Nitrokey/nitrokey-lora-hardware/Assembly/nk-LoRa-BOM.xlsx

BOM - NITROKEY LoRa Rev.1
Reference | Quantity | Value | Footprint | Manufacturer Part Number | Distributer Link
ANT1 | 1 | 2450 MHZ ANTENNA | footprints:9520_WiFiChipAntenna | 2450AT45A100E | https://www.mouser.de/ProductDetail/Johanson-Technology/2450AT45A100E
ANT2 | 1 | 868 MHZ ANTENNA | footprints:Ant_868MHz_0868AT43A0020E | 0868AT43A0020E | https://www.digikey.com/product-detail/en/johanson-technology-inc/0868AT43A0020E/712-1399-1-ND/1833757
C14 | 1 | 100pF | Capacitor_SMD:C_0402_1005Metric | GRM1555C1H101FA01J | https://www.mouser.de/ProductDetail/Murata-Electronics/GRM1555C1H101FA01J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
C16 C8 | 2 | 10uF | Capacitor_SMD:C_0603_1608Metric | GRM188R61A106KE69J | https://www.mouser.de/ProductDetail/Murata-Electronics/GRM188R61A106KE69J
C1 C12 C13 C17 | 4 | 1uF | Capacitor_SMD:C_0402_1005Metric | GRM155C81A105KA12D | https://www.mouser.de/ProductDetail/Murata-Electronics/GRM155C81A105KA12D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
C18 | 1 | 10n | Capacitor_SMD:C_0402_1005Metric | GRM155R71E103KA01D | https://www.mouser.de/ProductDetail/Murata-Electronics/GRM155R71E103KA01D
C19 | 1 | 4.7pF | Capacitor_SMD:C_0402_1005Metric | GJM1555C1H2R4CB01D | https://www.mouser.de/ProductDetail/Murata-Electronics/GJM1555C1H2R4CB01D
C2 C3 | 2 | 22pF/6.3V(10%) | Capacitor_SMD:C_0402_1005Metric | GRM1555C1H220FA01D (https://www.mouser.de/ProductDetail/Murata-Electronics/GRM1555C1H220FA01D) | https://www.mouser.de/ProductDetail/Murata-Electronics/GRM1555C1H220FA01D
C20 | 1 | 2.4pF | Capacitor_SMD:C_0402_1005Metric | GJM1555C1H2R4CB01J | https://www.mouser.de/ProductDetail/Murata-Electronics/GJM1555C1H2R4CB01J
C21 | 1 | 470nF | Capacitor_SMD:C_0402_1005Metric | GRM155R61A474KE15D | https://www.mouser.de/ProductDetail/Murata-Electronics/GRM155R61A474KE15D
C23 C25 C28 C31 | 4 | 3.3pF | Capacitor_SMD:C_0402_1005Metric | GRM1555C1H3R3BA01D | https://www.mouser.de/ProductDetail/Murata-Electronics/GRM1555C1H3R3BA01D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
C27 C40 | 2 | 1.8pF | Capacitor_SMD:C_0402_1005Metric | GRM1555C1H1R8BA01D | https://www.mouser.de/_/?Keyword=GRM1555C1H1R8BA01D
C26 C29 | 2 | 15pF | Capacitor_SMD:C_0402_1005Metric | GRM1555C1H150JA01D | https://www.mouser.de/ProductDetail/Murata-Electronics/GRM1555C1H150JA01D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
C30 | 1 | 12pF | Capacitor_SMD:C_0402_1005Metric | GRM1555C1H120JA01J | https://www.mouser.de/ProductDetail/Murata-Electronics/GRM1555C1H120JA01J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
C35 | 1 | 3.0pF | Capacitor_SMD:C_0402_1005Metric | GRM1555C1H3R0BA01D | https://www.mouser.de/ProductDetail/Murata-Electronics/GRM1555C1H3R0BA01D?qs=ouTquLLW2S5g5Yak4wnjeg%3D%3D
C37 | 1 | 47nF | Capacitor_SMD:C_0402_1005Metric | GRM155R71C473KA01J | https://www.mouser.de/ProductDetail/Murata-Electronics/GRM155R71C473KA01J
C38 | 1 | 47pF | Capacitor_SMD:C_0402_1005Metric | GJM1555C1H470FB01D | https://www.mouser.de/ProductDetail/Murata-Electronics/GJM1555C1H470FB01D
C39 | 1 | 6.8pF | Capacitor_SMD:C_0402_1005Metric | GRM1555C1H6R8BA01D | https://www.mouser.de/ProductDetail/Murata-Electronics/GRM1555C1H6R8BA01D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
C22 C4 | 2 | 10nF | Capacitor_SMD:C_0402_1005Metric | GRM155R71E103KA01D | https://www.mouser.de/ProductDetail/Murata-Electronics/GRM155R71E103KA01D
C41 | 1 | 1.0pF | Capacitor_SMD:C_0402_1005Metric | GRM1555C1H1R0BA01D | https://www.mouser.de/ProductDetail/Murata-Electronics/GRM1555C1H1R0BA01D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
C5 | 1 | 3,3nF | Capacitor_SMD:C_0402_1005Metric | GRM155R71H332JA01D | https://www.mouser.de/ProductDetail/Murata-Electronics/GRM155R71H332JA01D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
C7 | 1 | 22pF | Capacitor_SMD:C_0402_1005Metric | GRM1555C1H220JA01D | https://www.mouser.de/ProductDetail/Murata-Electronics/GRM1555C1H220JA01D
C10 C11 C15 C24 C6 C9 | 6 | 0.1uF | Capacitor_SMD:C_0402_1005Metric | GRM155R71C104KA88D | https://www.mouser.de/ProductDetail/Murata-Electronics/GRM155R71C104KA88D
D1 | 1 | LED_0402 | LED_SMD:LED_0402_1005Metric | APHHS1005SURCK | https://www.mouser.de/ProductDetail/Kingbright/APHHS1005SURCK
L1 | 1 | 2.4nH | Inductor_SMD:L_0402_1005Metric | LQP15MN2N4B02D | https://www.mouser.de/ProductDetail/Murata-Electronics/LQP15MN2N4B02D
L10 | 1 | 18nH | Inductor_SMD:L_0402_1005Metric | LQW15AN18NH00D | https://www.mouser.de/ProductDetail/Murata-Electronics/LQW15AN18NH00D
L12 | 1 | 2.7nH | Inductor_SMD:L_0402_1005Metric | LQW15AN2N7C00D | https://www.mouser.de/ProductDetail/Murata-Electronics/LQW15AN2N7C00D
L11 L2 | 2 | 47nH | Inductor_SMD:L_0402_1005Metric | LQW15AN47NJ00D | https://www.mouser.de/ProductDetail/Murata-Electronics/LQW15AN47NJ00D
L3 L5 | 2 | 9.1nH | Inductor_SMD:L_0402_1005Metric | LQW15AN9N1H00D | https://www.mouser.de/ProductDetail/Murata-Electronics/LQW15AN9N1H00D
L9 | 1 | 15uH | Inductor_SMD:L_0805_2012Metric | MLZ2012M150W | https://www.mouser.de/ProductDetail/TDK/MLZ2012M150WTD25
Q1 | 1 | MBT3904DW1T1G | Package_TO_SOT_SMD:SOT-363_SC-70-6 | http://www.onsemi.com/pub/Collateral/MBT3904DW1T1-D.PDF | https://www.mouser.de/ProductDetail/ON-Semiconductor/MBT3904DW1T1G
R10 R12 R4 R9 | 4 | 10K | Resistor_SMD:R_0402_1005Metric | http://www.vishay.com/docs/20035/dcrcwe3.pdf | https://www.mouser.de/ProductDetail/Vishay-Dale/CRCW040210K0FKED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
R13 R14 R15 R16 R17 R18 | 6 | 47K | Resistor_SMD:R_0402_1005Metric | http://www.vishay.com/docs/20035/dcrcwe3.pdf | Vishay Standard
R19 | 1 | 50K | Resistor_SMD:R_0402_1005Metric | http://www.vishay.com/docs/20035/dcrcwe3.pdf | Vishay Standard
R1 R11 R2 | 3 | 1K | Resistor_SMD:R_0402_1005Metric | http://www.vishay.com/docs/20035/dcrcwe3.pdf | Vishay Standard
R20 R21 | 2 | 100R | Resistor_SMD:R_0402_1005Metric | http://www.vishay.com/docs/20035/dcrcwe3.pdf | Vishay Standard
R3 | 1 | 20K | Resistor_SMD:R_0402_1005Metric | http://www.vishay.com/docs/20035/dcrcwe3.pdf | Vishay Standard
R5 | 1 | 390R | Resistor_SMD:R_0402_1005Metric | http://www.vishay.com/docs/20035/dcrcwe3.pdf | Vishay Standard
R6 | 1 | 1M | Resistor_SMD:R_0402_1005Metric | http://www.vishay.com/docs/20035/dcrcwe3.pdf | Vishay Standard
R7 | 1 | 22.1K | Resistor_SMD:R_0402_1005Metric | http://www.vishay.com/docs/20035/dcrcwe3.pdf | Vishay Standard
R8 | 1 | 47.5K | Resistor_SMD:R_0402_1005Metric | http://www.vishay.com/docs/20035/dcrcwe3.pdf | Vishay Standard
U1 | 1 | TLV75733PDBVR | footprints:SOT-23-5 | TLV75733PDBVR | https://www.mouser.de/ProductDetail/Texas-Instruments/TLV75733PDBVR
U2 | 1 | ESP32-D0WD | Package_DFN_QFN:QFN-48-1EP_5x5mm_P0.35mm_EP3.7x3.7mm_ThermalVias | Smd Ic Esp32-D0wd, Dual Core Mcu, Espressif Systems | https://www.mouser.de/ProductDetail/Espressif-Systems/ESP32-D0WD
U3 | 1 | SX1261IMLTRT | footprints:QFN-24-1EP_4x4mm_P0.5mm_EP2.7x2.7mm_ThermalVias | RF Transceiver FSK 1.8V to 3.7V 150MHz to 960MHz 24-Pin QFN | https://www.mouser.de/ProductDetail/Semtech/SX1261IMLTRT?qs=XFmntM7Yc9ddMzW%252Bp3zsFQ==
U4 | 1 | DF5A5.6JE | Package_TO_SOT_SMD:SOT-553 | http://optoelectronics.liteon.com/upload/download/DS22-2008-0044/S_110_LTST-C19HE1WT.pdf | https://www.mouser.de/ProductDetail/Toshiba/DF5A56JELM
U5 | 1 | CP2102N-A01-GQFN24 | Package_DFN_QFN:QFN-24-1EP_4x4mm_P0.5mm_EP2.6x2.6mm | CP2102N-A01-GQFN24 | https://www.mouser.de/ProductDetail/Silicon-Labs/CP2102N-A01-GQFN24
U6 | 1 | RF-Switch_pSemi_4259-63 | footprints:SC-70-6 | RF-Switch_pSemi_4259-63 | https://www.digikey.com/product-detail/en/psemi/4259-63/1046-1011-1-ND/2614515
X1 | 1 | FA-128 40MHz | Crystal:Crystal_SMD_2016-4Pin_2.0x1.6mm | FA-128 40MHz | https://www.digikey.com/product-detail/en/epson/FA-128-40.0000MF10Z-K3/SER3753CT-ND/2514633
X2 | 1 | USB_Plug | footprints:USB-A-PLUG | USB_Plug | 0480372200_sd
X3 | 1 | Micro_SD_Card_Molex_475710001 | footprints:47571-0001 | Micro_SD_Card_Molex_475710001 | https://www.digikey.de/product-detail/de/molex/0475710001/WM9731CT-ND/4037907
Y1 | 1 | Q 32,0-JXS21-10-10/10-FU-WA-LF | Crystal:Crystal_SMD_2016-4Pin_2.0x1.6mm | Q 32,0-JXS21-10-10/10-FU-WA-LF | https://www.digikey.com/product-detail/en/jauch-quartz/Q-320-JXS21-10-10-10-FU-WA-LF/1908-1280-1-ND/8108392
