Nitrokey/nitrokey-lora-hardware/3DLib/case_top.dxf

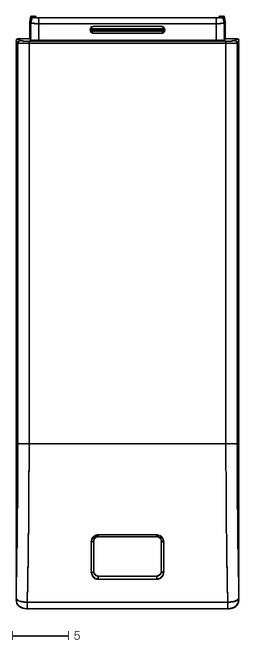
[picture p1: CAD file, 2019-06-24]
3DLib/case_top.dxf
19.8 x 52.6
