Nitrokey/nitrokey-lora-hardware/3DLib/AN9520.step

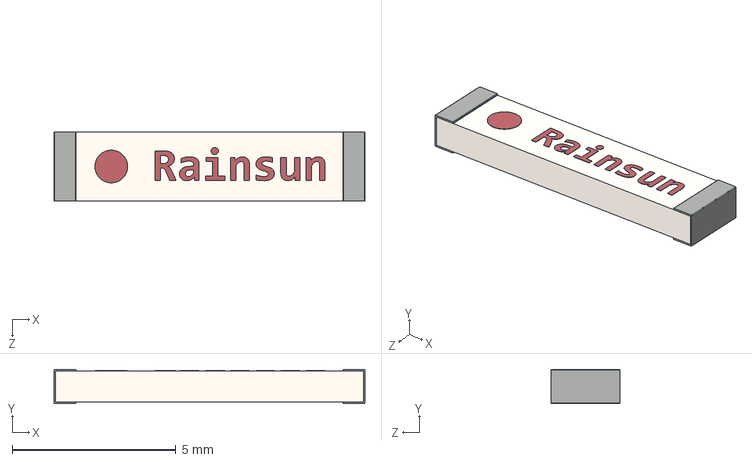
[picture p2: CAD file, 2019-06-24]
3DLib/AN9520.step
9.50 x 1.05 x 2.10 mm
