Nitrokey/nitrokey-lora-hardware/3DLib/Micro_SD.step

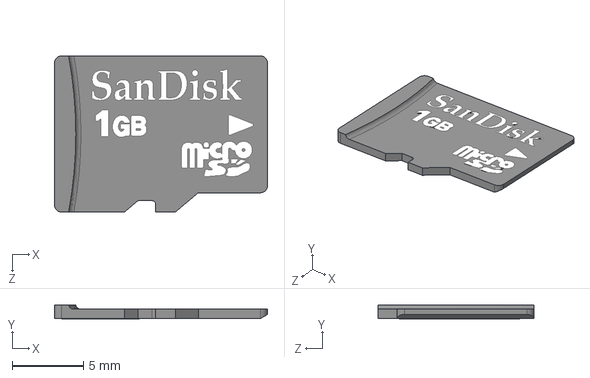
[picture p3: CAD file, 2019-06-24]
3DLib/Micro_SD.step
15.0 x 0.975 x 11.0 mm
