Nitrokey/nitrokey-lora-hardware/3DLib/case_bottom.step

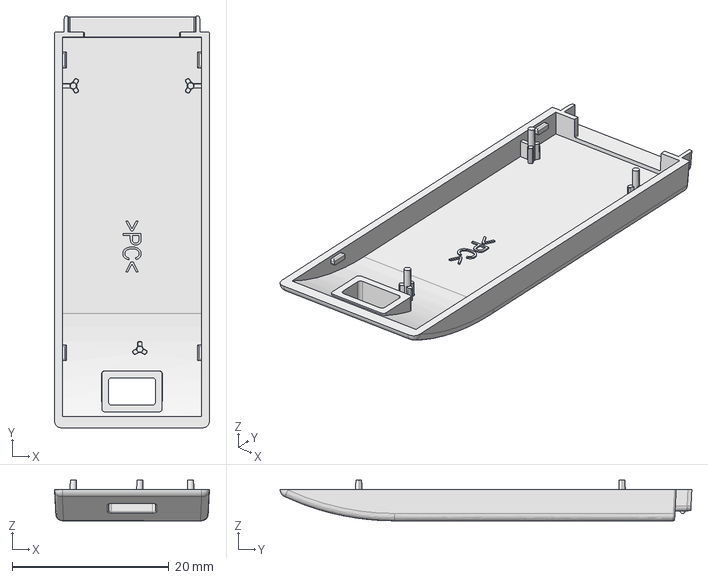
[picture p4: CAD file, 2019-06-24]
3DLib/case_bottom.step
19.8 x 52.6 x 5.20 mm
