Nitrokey/nitrokey-lora-hardware/3DLib/case_bottom+pcb.dxf

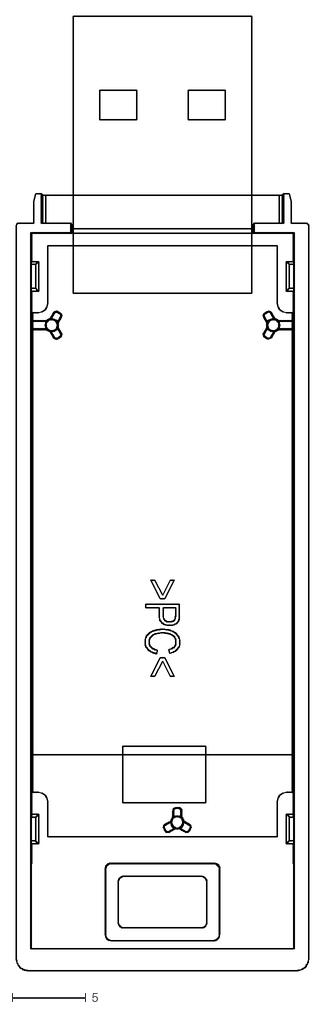
[picture p5: CAD file, 2019-06-24]
3DLib/case_bottom+pcb.dxf
19.8 x 64.6
