Nitrokey/nitrokey-lora-hardware/3DLib/case_cap.dxf

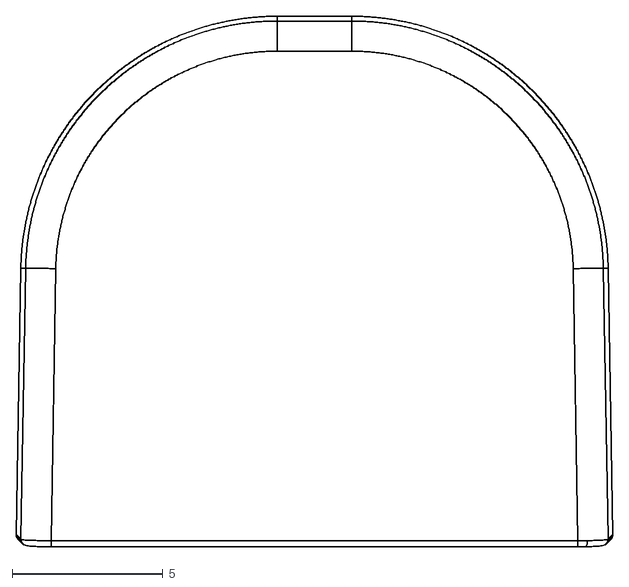
[picture p6: CAD file, 2019-06-24]
3DLib/case_cap.dxf
19.8 x 17.6
