Nitrokey/nitrokey-lora-hardware/3DLib/sot363_sc70_6.step

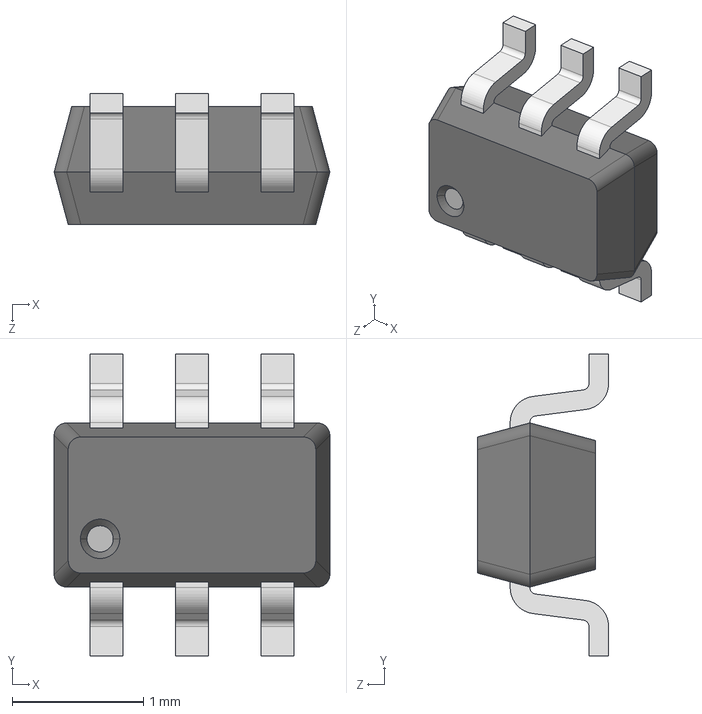
[picture p7: CAD file, 2019-06-24]
3DLib/sot363_sc70_6.step
2.10 x 2.30 x 1.00 mm
