Nitrokey/nitrokey-lora-hardware/3DLib/Crystal 2.0mm x 1.6mm x 0.7mm.step

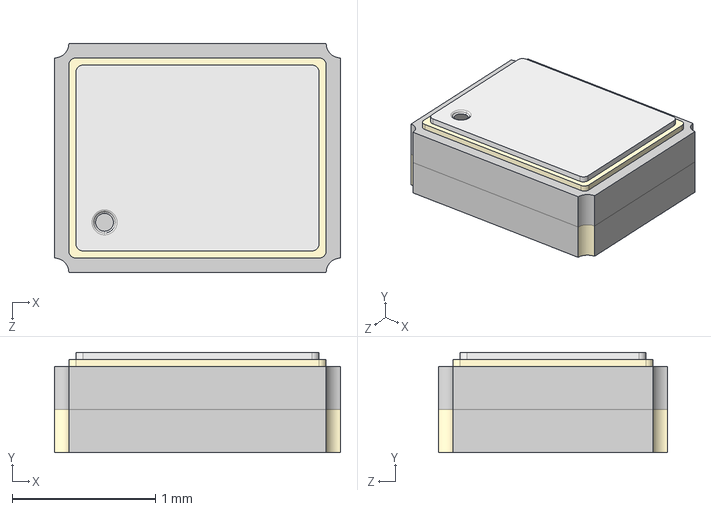
[picture p8: CAD file, 2019-06-24]
3DLib/Crystal 2.0mm x 1.6mm x 0.7mm.step
2.00 x 0.701 x 1.60 mm
