Nitrokey/nitrokey-lora-hardware/3DLib/QFN-48-1EP_5x5mm_P0.35mm_EP3.7x3.7mm.step

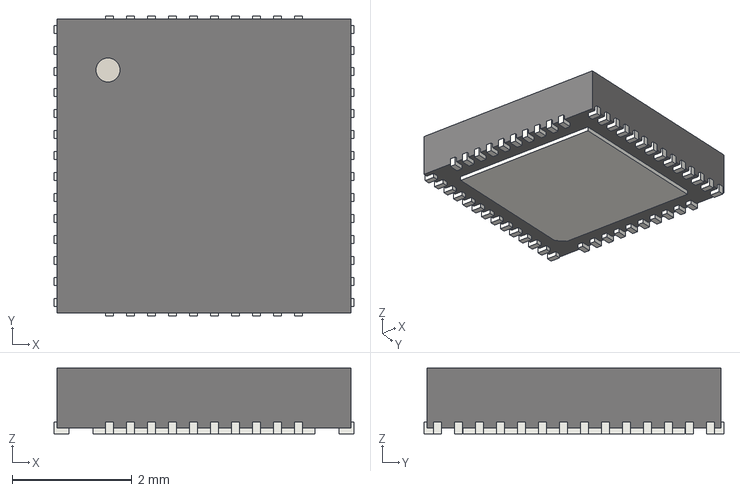
[picture p9: CAD file, 2019-06-24]
3DLib/QFN-48-1EP_5x5mm_P0.35mm_EP3.7x3.7mm.step
5.00 x 5.00 x 1.10 mm
