Nitrokey/nitrokey-lora-hardware/3DLib/User Library-0868AT43A0020.step

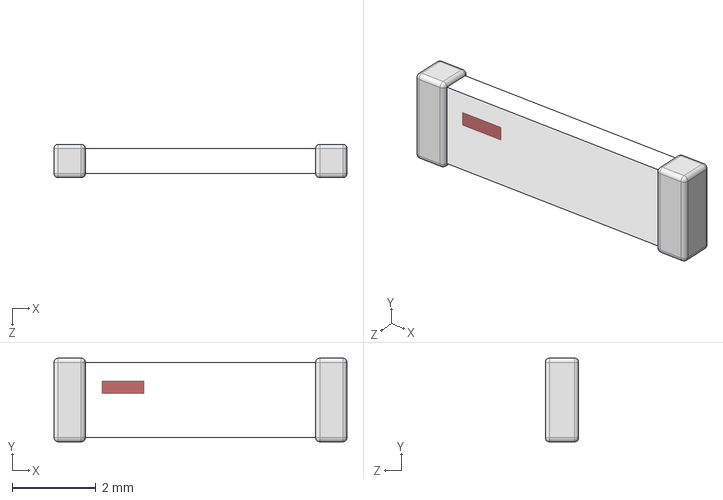
[picture p10: CAD file, 2019-06-24]
3DLib/User Library-0868AT43A0020.step
7.00 x 2.00 x 0.8 mm
