Nitrokey/nitrokey-lora-hardware/3DLib/case_top_cap.step

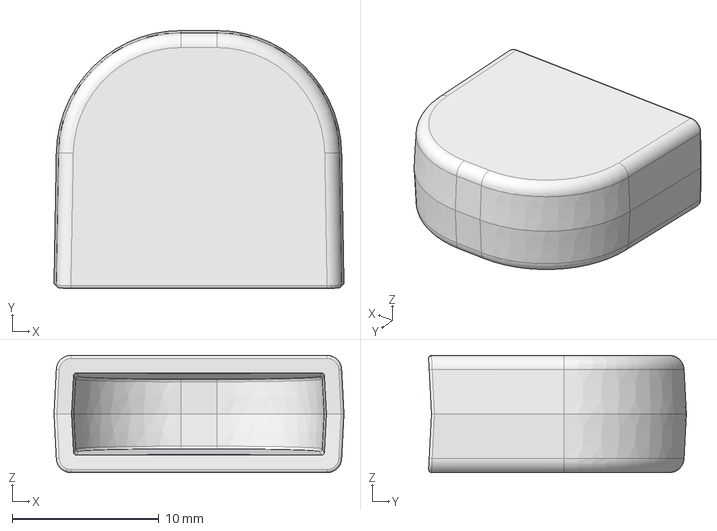
[picture p11: CAD file, 2019-06-24]
3DLib/case_top_cap.step
19.8 x 17.6 x 8.00 mm
