Nitrokey/nitrokey-lora-hardware/3DLib/top_case.step

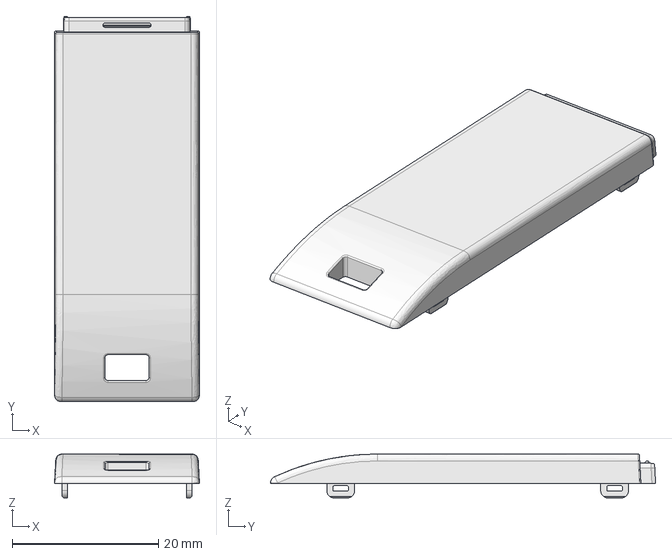
[picture p12: CAD file, 2019-06-24]
3DLib/top_case.step
19.8 x 52.6 x 6.00 mm
