Nitrokey/nitrokey-lora-hardware/3DLib/QFN24.step

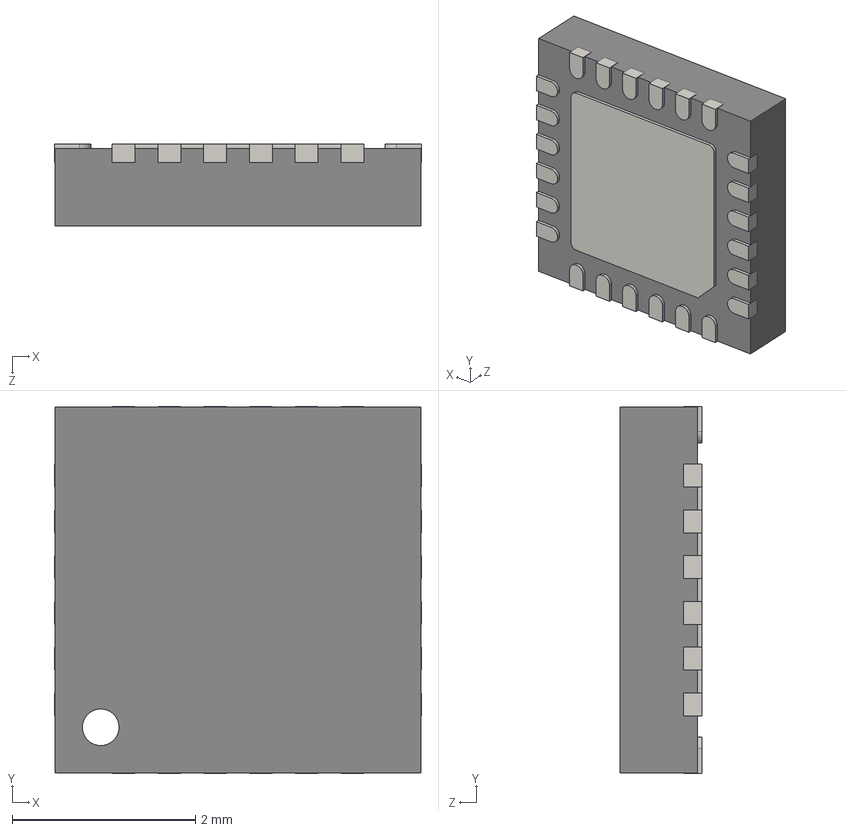
[picture p13: CAD file, 2019-06-24]
3DLib/QFN24.step
4.01 x 4.01 x 0.9 mm
