Nitrokey/nitrokey-lora-hardware/3DLib/1462360101.stp

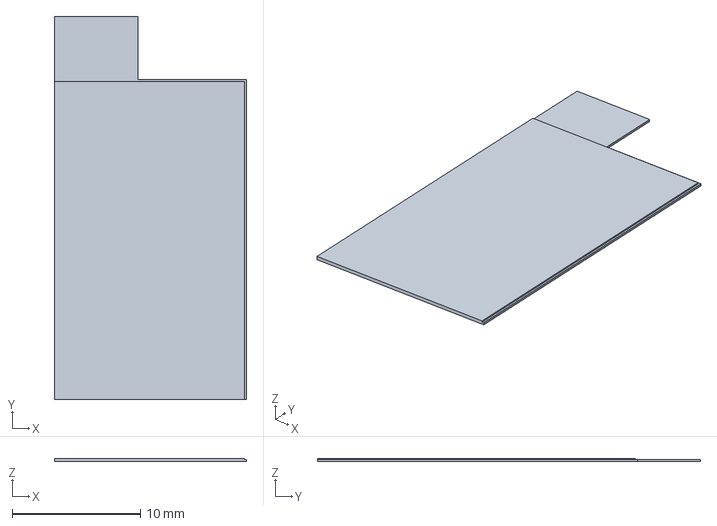
[picture p14: CAD file, 2019-06-24]
3DLib/1462360101.stp
15.0 x 29.9 x 0.27 mm
