Nitrokey/nitrokey-lora-hardware/3DLib/475710001.stp

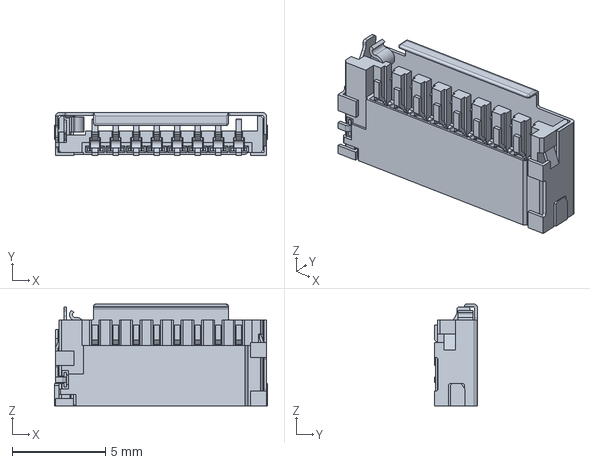
[picture p15: CAD file, 2019-06-24]
3DLib/475710001.stp
11.4 x 2.30 x 5.45 mm
