Nitrokey/nitrokey-lora-hardware/3DLib/1040310811.stp

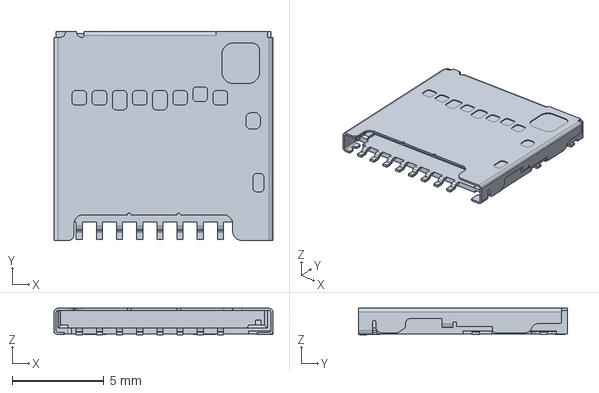
[picture p16: CAD file, 2019-06-24]
3DLib/1040310811.stp
11.9 x 11.4 x 1.45 mm
