Nitrokey/nitrokey-lora-hardware/3DLib/1140084168_3d.STEP

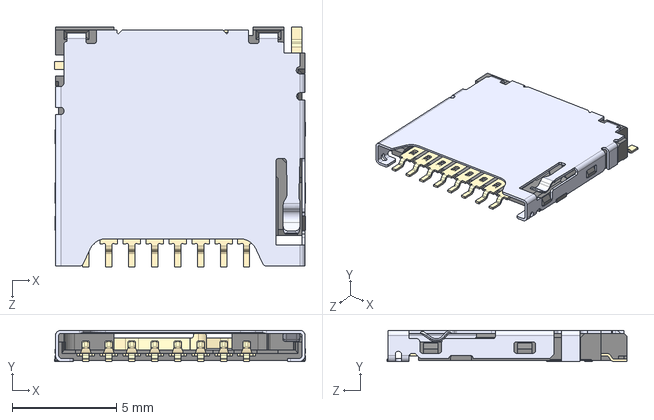
[picture p17: CAD file, 2019-06-24]
3DLib/1140084168_3d.STEP
12.0 x 1.50 x 11.5 mm
