Nitrokey/nitrokey-lora-hardware/(list of files, cad)

Other CAD files:
3DLib/case_bottom.dxf
