Nitrokey/nitrokey-lora-hardware/nk-LoRa_Schaltplan.pdf

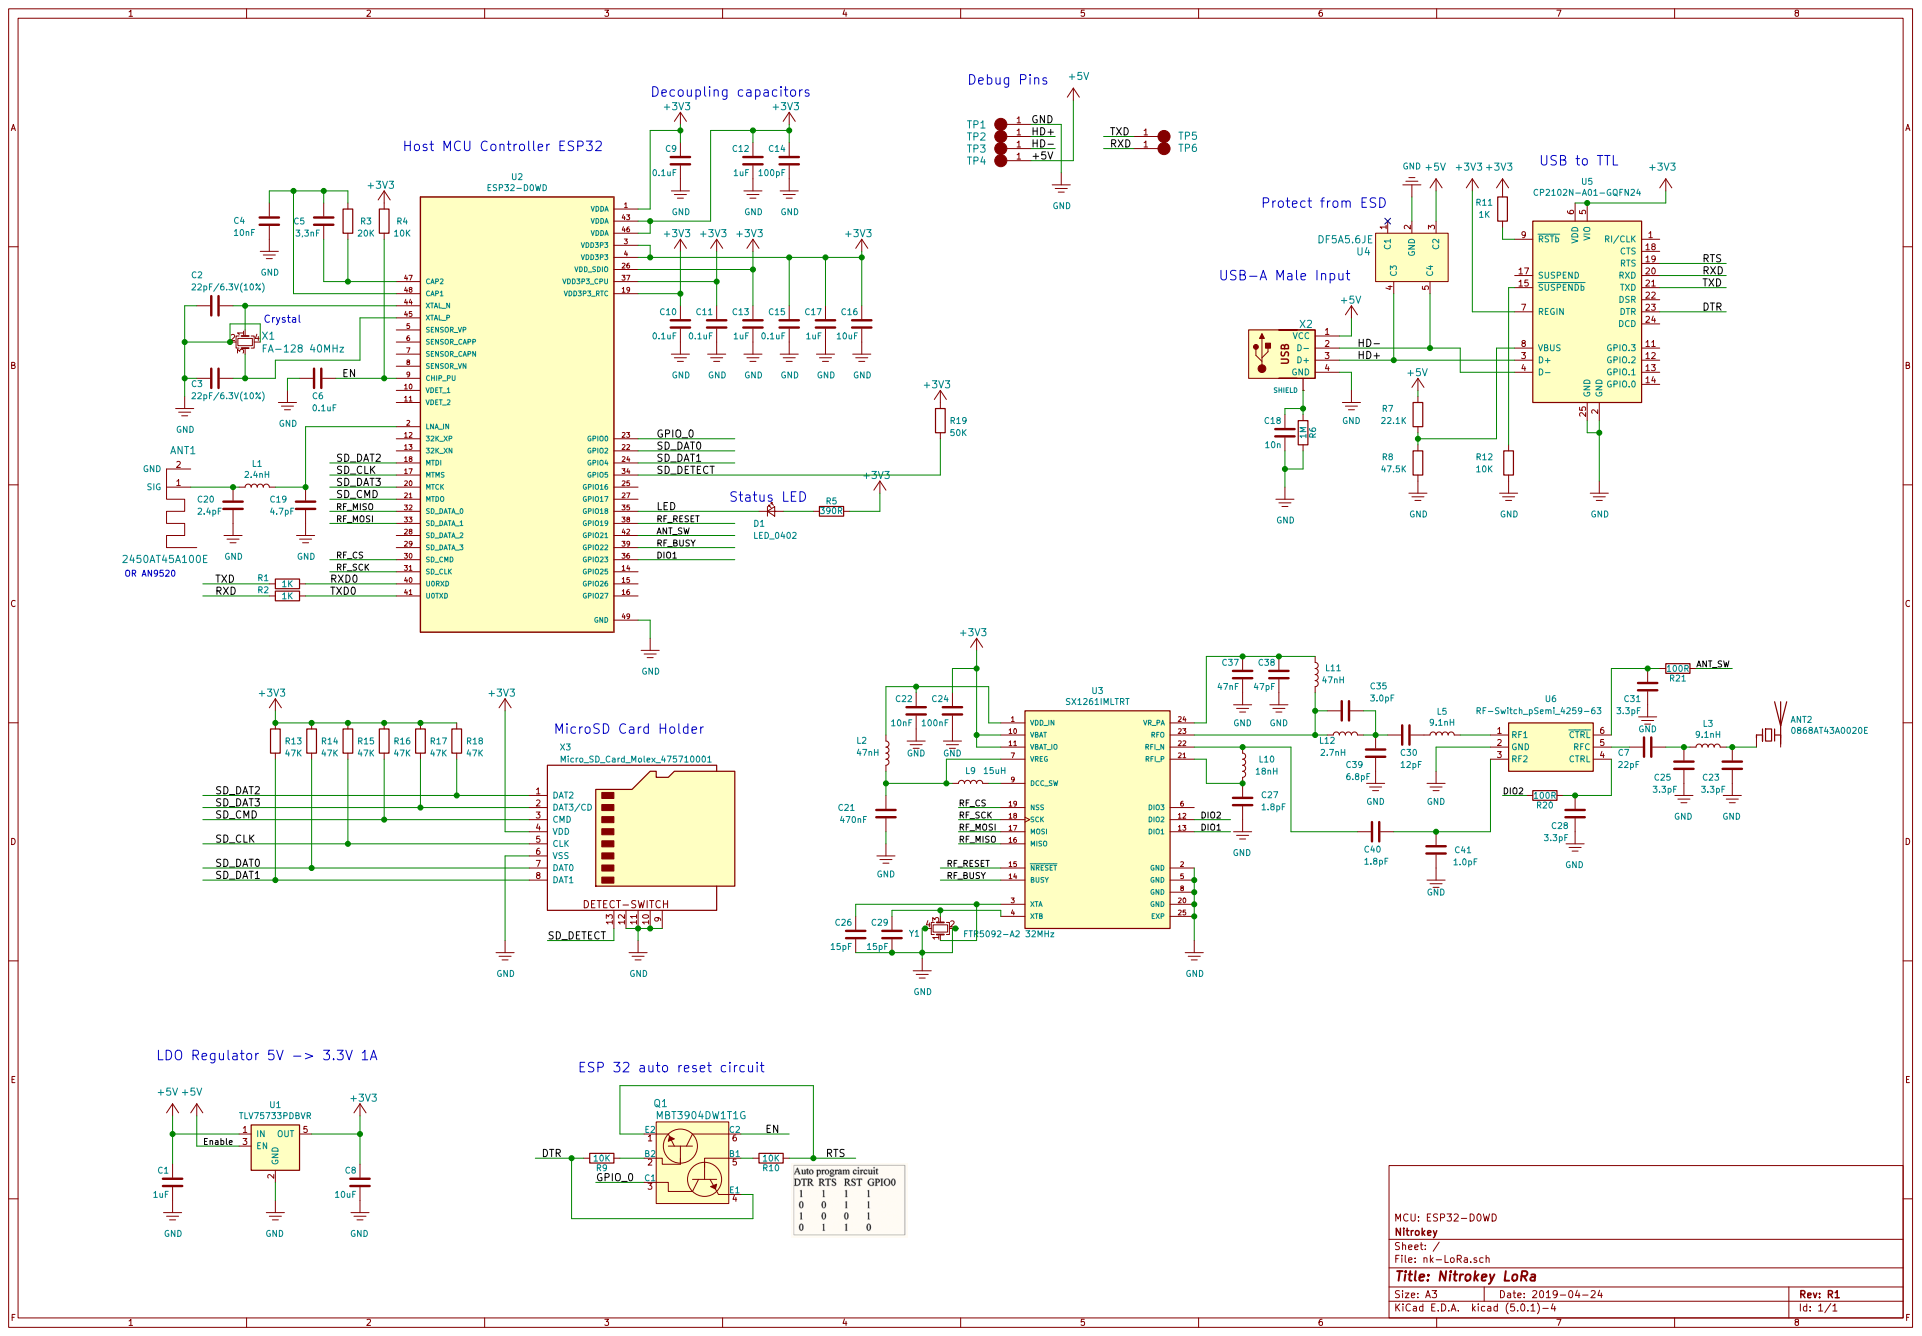
[picture p18: page 1]

TXD
RXD
File: nk-LoRa.sch Sheet: / Nitrokey MCU: ESP32-D0WD C1

LED Host MCU Controller ESP32

6 REGIN 7 VBUS 8 RSTb 9 U5 CP2102N-A01-GQFN24 GND
1 GPIO.3
RI/CLK
18 RTS

+5V ESP 32 auto reset circuit

Id: 1/1 Title: Nitrokey LoRa
