Nitrokey/nitrokey-lora-hardware/nk-LoRa.kicad_pcb

## KiCad design nk-LoRa.kicad_pcb (2019-07-25)

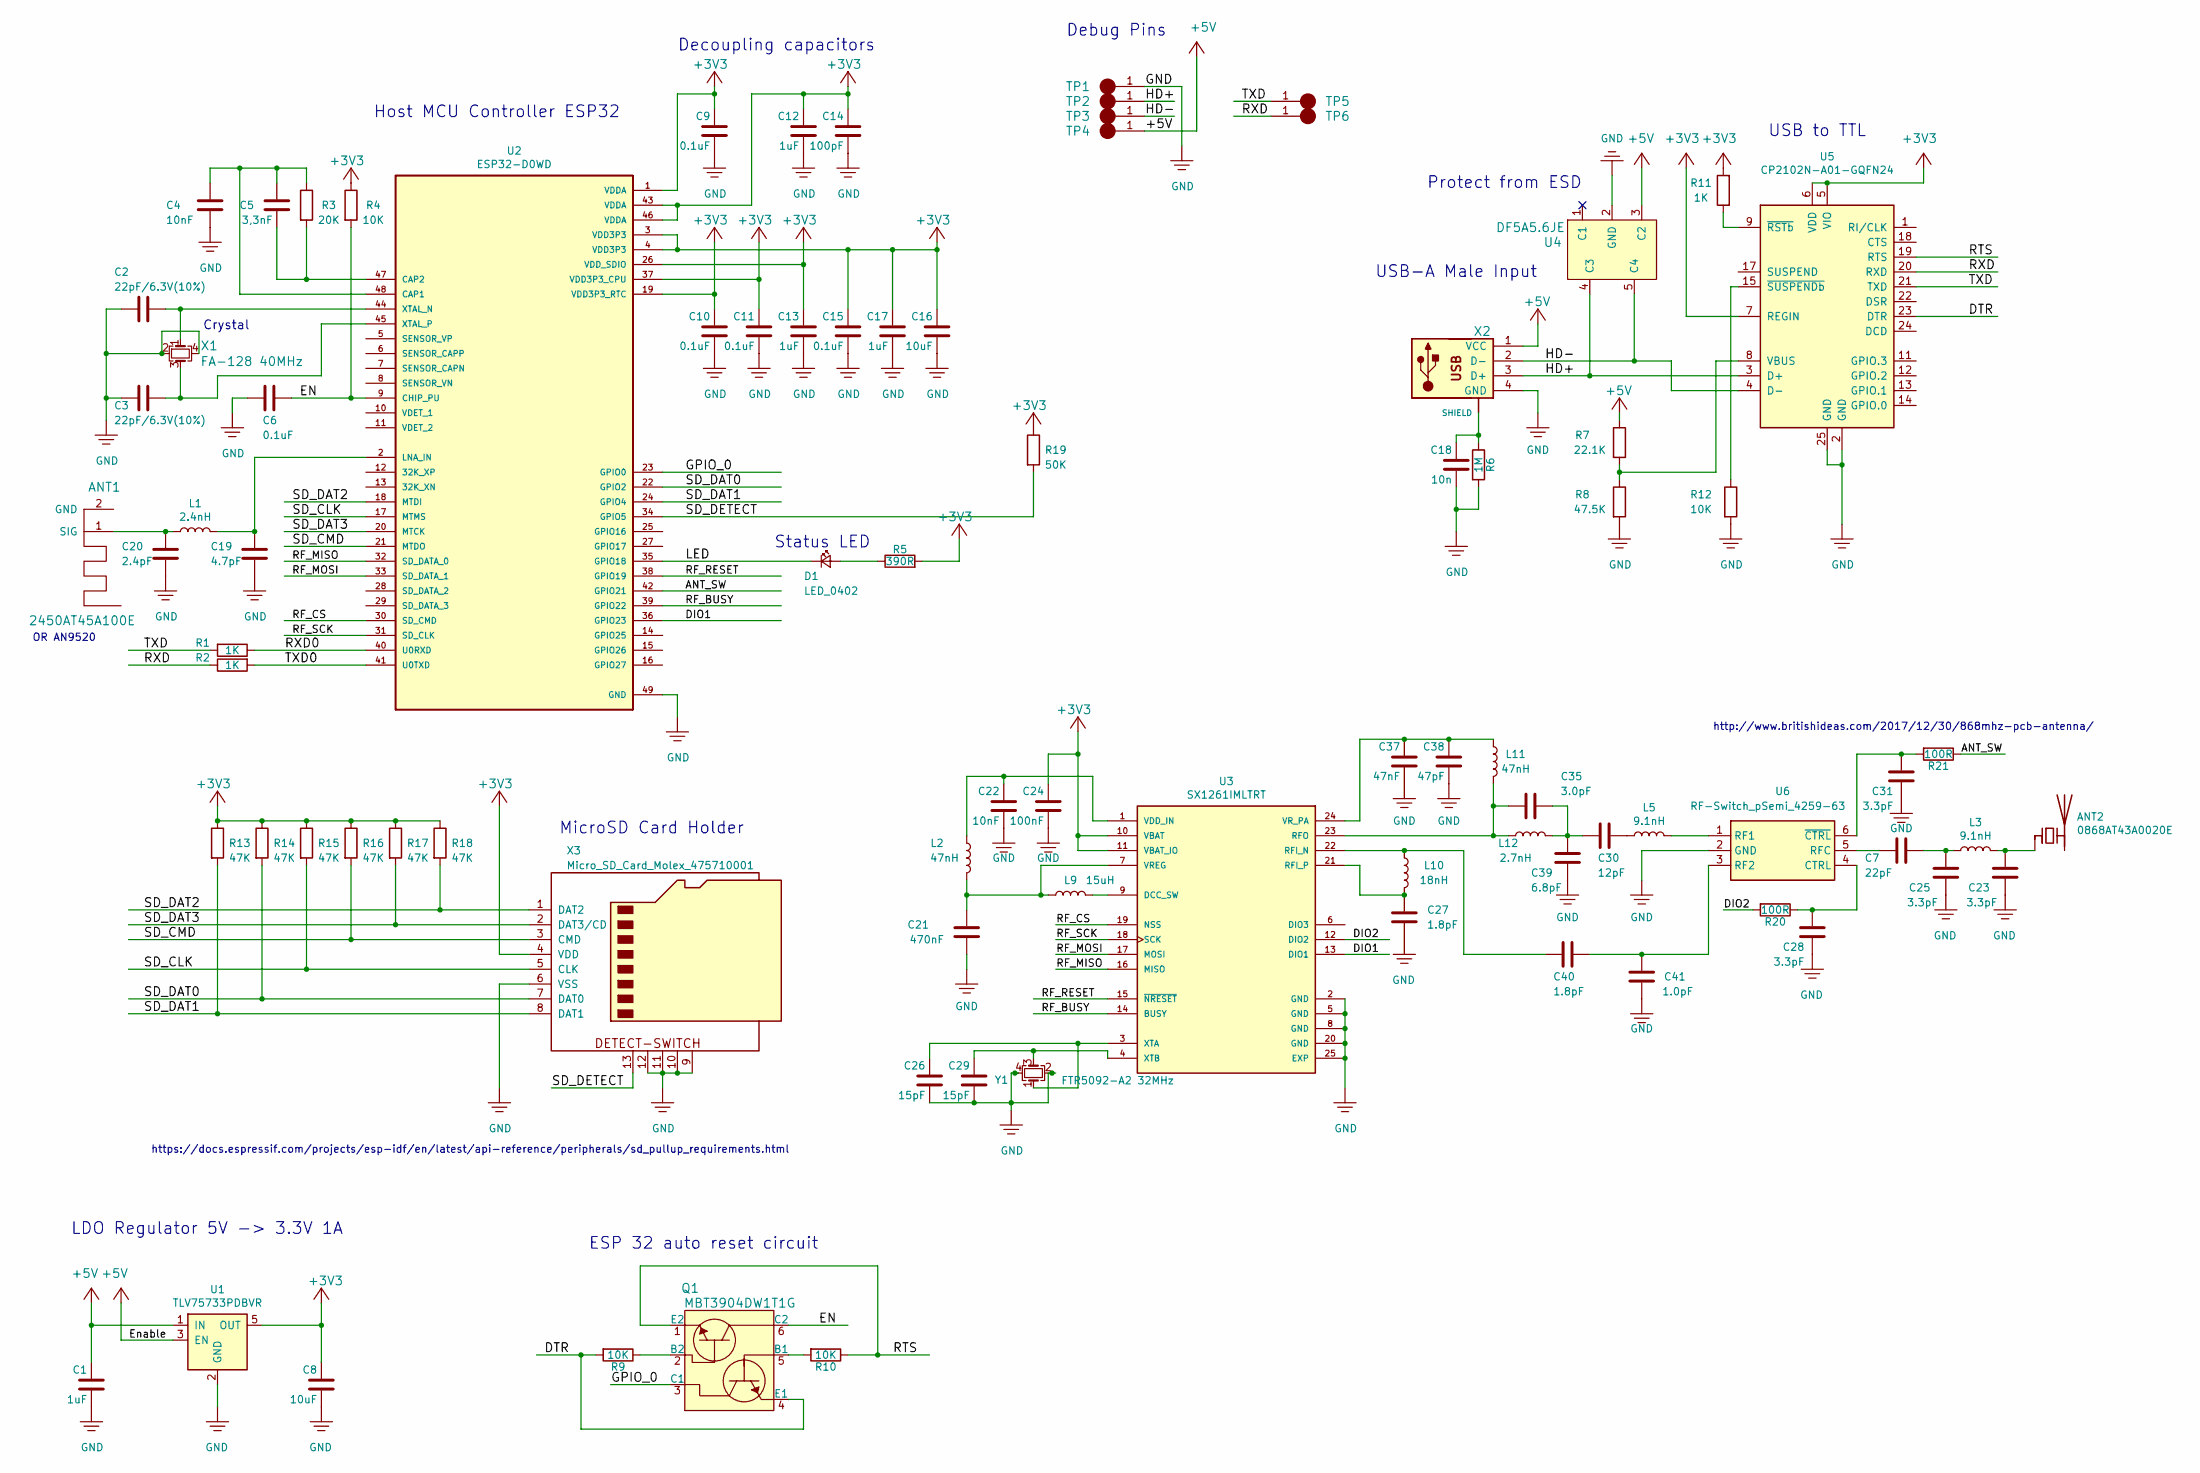
[picture p28: schematic nk-LoRa.sch, Nitrokey LoRa]

Parts:
ANT1: 2450AT45A100E; 9520_WiFiChipAntenna
ANT2: 0868AT43A0020E; Ant_868MHz_0868AT43A0020E
C1, C12, C13, C17: 1uF; C_0402_1005Metric; MFG Part Num ?
C2, C3: 22pF/6.3V(10%); C_0402_1005Metric; MFG Part Num ?
C4, C22: 10nF; C_0402_1005Metric; MFG Part Num ?
C5: 3,3nF; C_0402_1005Metric; MFG Part Num ?
C6, C9, C10, C11, C15: 0.1uF; C_0402_1005Metric; MFG Part Num ?
C7: 22pF; C_0402_1005Metric
C8, C16: 10uF; C_0603_1608Metric; MFG Part Num ?
C14: 100pF; C_0402_1005Metric; MFG Part Num ?
C18: 10n; C_0402_1005Metric; MFG Part Num ?
C19: 4.7pF; C_0402_1005Metric
C20: 2.4pF; C_0402_1005Metric
C21: 470nF; C_0402_1005Metric; MFG Part Num GRM155R61A474KE15D
C23, C25, C28, C31: 3.3pF; C_0402_1005Metric
C24: 100nF; C_0402_1005Metric; MFG Part Num GRM155R71C104KA88D
C26, C29: 15pF; C_0402_1005Metric; MFG Part Num GRM1555C1H150JA01D
C27, C40: 1.8pF; C_0402_1005Metric; MFG Part Num GRM1555C1H1R8BA01D
C30: 12pF; C_0402_1005Metric
C35: 3.0pF; C_0402_1005Metric; MFG Part Num GRM1555C1H3R0BA01D
C37: 47nF; C_0402_1005Metric; MFG Part Num ?
C38: 47pF; C_0402_1005Metric; MFG Part Num ?
C39: 6.8pF; C_0402_1005Metric; MFG Part Num GRM1555C1H6R8BA01D
C41: 1.0pF; C_0402_1005Metric
D1: LED_0402; LED_0402_1005Metric
L1: 2.4nH; L_0402_1005Metric; Part.Nr LQP15MN2N4B02D
L2, L11: 47nH; L_0402_1005Metric; Part.Nr LQW15AN47NJ00D
L3, L5: 9.1nH; L_0402_1005Metric; Part.Nr LQW15AN9N1H00D
L9: 15uH; L_0805_2012Metric; Part.Nr MLZ2012M150W
L10: 18nH; L_0402_1005Metric; Part.Nr LQW15AN18NH00D
L12: 2.7nH; L_0402_1005Metric; Part.Nr LQW15AN2N7C00D
Q1: MBT3904DW1T1G; SOT-363_SC-70-6; MPN MBT3904DW1T1G; Digi-Key_PN MBT3904DW1T1GOSCT-ND
R1, R2, R11: 1K; R_0402_1005Metric; MFG Part Num ?
R3: 20K; R_0402_1005Metric; MFG Part Num ?
R4, R9, R10, R12: 10K; R_0402_1005Metric; MFG Part Num ?
R5: 390R; R_0402_1005Metric; MFG Part Num ?
R6: 1M; R_0402_1005Metric; MFG Part Num ?
R7: 22.1K; R_0402_1005Metric; MFG Part Num ?
R8: 47.5K; R_0402_1005Metric; MFG Part Num ?
R13, R14, R15, R16, R17, R18: 47K; R_0402_1005Metric; MFG Part Num ?
R19: 50K; R_0402_1005Metric; MFG Part Num ?
R20, R21: 100R; R_0402_1005Metric; MFG Part Num ?
TP1, TP2, TP3, TP4, TP5, TP6: debug-pin; Prog_Pad_Circular
U1: TLV75733PDBVR; SOT-23-5
U2: ESP32-D0WD; QFN-48-1EP_5x5mm_P0.35mm_EP3.7x3.7mm_ThermalVias
U3: SX1261IMLTRT; QFN-24-1EP_4x4mm_P0.5mm_EP2.7x2.7mm_ThermalVias
U4: DF5A5.6JE; SOT-553; MFG Part Num DF5A5.6JE,LM
U5: CP2102N-A01-GQFN24; QFN-24-1EP_4x4mm_P0.5mm_EP2.6x2.6mm
U6: RF-Switch_pSemi_4259-63; SC-70-6
X1: FA-128 40MHz; Crystal_SMD_2016-4Pin_2.0x1.6mm
X2: USB_Plug; USB-A-PLUG
X3: Micro_SD_Card_Molex_475710001; 47571-0001
Y1: FTR5092-A2 32MHz; Crystal_SMD_2016-4Pin_2.0x1.6mm

Connections:
+3V3: C8.1, C9.1, C10.1, C11.1, C12.1, C13.1, C14.1, C15.1, C16.1, C17.1, C24.1, R4.1, R5.2, R11.2, R13.1, R14.1, R15.1, R16.1, R17.1, R18.1, R19.1, U1.5 (OUT), U2.1 (VDDA), U2.3 (VDD3P3), U2.4 (VDD3P3), U2.19 (VDD3P3_RTC), U2.26 (VDD_SDIO), U2.37 (VDD3P3_CPU), U2.43 (VDDA), U2.46 (VDDA), U3.10 (VBAT), U3.11 (VBAT_IO), U5.5 (VIO), U5.6 (VDD), U5.7 (REGIN), X3.4 (VDD)
+5V: C1.1, R7.1, TP4.1, U1.1 (IN), U1.3 (EN), U4.3 (C2), X2.1 (VCC)
/ANT_SW: R21.1, U2.42 (GPIO21)
/DIO1: U2.36 (GPIO23), U3.13 (DIO1)
/DIO2: R20.2, U3.12 (DIO2)
/DTR: Q1.4 (E1), R9.2, U5.23 (DTR)
/EN: C6.1, Q1.6 (C2), R4.2, U2.9 (CHIP_PU)
/GPIO_0: Q1.3 (C1), U2.23 (GPIO0)
/HD+: TP2.1, U4.4 (C3), U5.3 (D+), X2.3 (D+)
/HD-: TP3.1, U4.5 (C4), U5.4 (D-), X2.2 (D-)
/LED: D1.1 (K), U2.35 (GPIO18)
/RF_BUSY: U2.39 (GPIO22), U3.14 (BUSY)
/RF_CS: U2.30 (SD_CMD), U3.19 (NSS)
/RF_MISO: U2.32 (SD_DATA_0), U3.16 (MISO)
/RF_MOSI: U2.33 (SD_DATA_1), U3.17 (MOSI)
/RF_RESET: U2.38 (GPIO19), U3.15 (~NRESET~)
/RF_SCK: U2.31 (SD_CLK), U3.18 (SCK)
/RTS: Q1.1 (E2), R10.1, U5.19 (RTS)
/RXD: R2.1, TP6.1, U5.20 (RXD)
/RXD0: R1.1, U2.40 (U0RXD)
/SD_CLK: R15.2, U2.17 (MTMS), X3.5 (CLK)
/SD_CMD: R16.2, U2.21 (MTDO), X3.3 (CMD)
/SD_DAT0: R14.2, U2.22 (GPIO2), X3.7 (DAT0)
/SD_DAT1: R13.2, U2.24 (GPIO4), X3.8 (DAT1)
/SD_DAT2: R18.2, U2.18 (MTDI), X3.1 (DAT2)
/SD_DAT3: R17.2, U2.20 (MTCK), X3.2 (DAT3/CD)
/SD_DETECT: R19.2, U2.34 (GPIO5), X3.13 (GND)
/TXD: R1.2, TP5.1, U5.21 (TXD)
/TXD0: R2.2, U2.41 (U0TXD)
GND: C1.2, C2.2, C3.2, C4.1, C6.2, C8.2, C9.2, C10.2, C11.2, C12.2, C13.2, C14.2, C15.2, C16.2, C17.2, C18.2, C19.2, C20.2, C21.2, C22.2, C23.2, C24.2, C25.2, C26.2, C27.1, C28.2, C29.2, C31.2, C37.2, C38.2, C39.1, C41.2, R6.2, R8.2, R12.2, TP1.1, U1.2 (GND), U2.49 (GND), U3.2 (GND), U3.5 (GND), U3.8 (GND), U3.20 (GND), U3.25 (EXP), U4.2 (GND), U5.2 (GND), U5.25 (GND), U6.2 (GND), X1.2, X1.4, X2.4 (GND), X3.6 (VSS), X3.9 (SW1), X3.10 (SW2), X3.11 (GND), X3.12 (GND), Y1.2, Y1.4
unnamed: ANT1.1 (SIG), C20.1, L1.1
unnamed: ANT2.1 (FEED), C23.1, L3.1
unnamed: C2.1, U2.44 (XTAL_N), X1.1
unnamed: C3.1, U2.45 (XTAL_P), X1.3
unnamed: C4.2, C5.1, R3.1, U2.48 (CAP1)
unnamed: C5.2, R3.2, U2.47 (CAP2)
unnamed: C7.2, U6.5 (RFC)
unnamed: C18.1, R6.1, X2.5 (NC1), X2.6 (SHIELD)
unnamed: C19.1, L1.2, U2.2 (LNA_IN)
unnamed: C21.1, L2.1, L9.2, U3.7 (VREG)
unnamed: C22.1, L2.2, U3.1 (VDD_IN)
unnamed: C7.1, C25.1, L3.2
unnamed: C26.1, U3.3 (XTA), Y1.1
unnamed: C27.2, L10.2, U3.21 (RFI_P)
unnamed: C28.1, R20.1, U6.4 (CTRL)
unnamed: C29.1, U3.4 (XTB), Y1.3
unnamed: C30.1, L5.2
unnamed: C30.2, C35.1, C39.2, L12.2
unnamed: C31.1, R21.2, U6.6 (~CTRL)
unnamed: C35.2, L11.1, L12.1, U3.23 (RFO)
unnamed: C37.1, C38.1, L11.2, U3.24 (VR_PA)
unnamed: C40.1, C41.1, U6.3 (RF2)
unnamed: C40.2, L10.1, U3.22 (RFI_N)
unnamed: D1.2 (A), R5.1
unnamed: L5.1, U6.1 (RF1)
unnamed: L9.1, U3.9 (DCC_SW)
unnamed: Q1.2 (B2), R9.1
unnamed: Q1.5 (B1), R10.2
unnamed: R7.2, R8.1, U5.8 (VBUS)
unnamed: R11.1, U5.9 (~RSTb)
unnamed: R12.1, U5.15 (~SUSPENDb)

Notes on the sheet:
Protect from ESD
USB-A Male Input
Host MCU Controller ESP32
Status LED
Decoupling capacitors
Debug Pins
ESP 32 auto reset circuit
USB to TTL
MicroSD Card Holder
Crystal
http://www.britishideas.com/2017/12/30/868mhz-pcb-antenna/
https://docs.espressif.com/projects/esp-idf/en/latest/api-reference/peripherals/sd_pullup_requirements.html
OR AN9520
LDO Regulator 5V -> 3.3V 1A

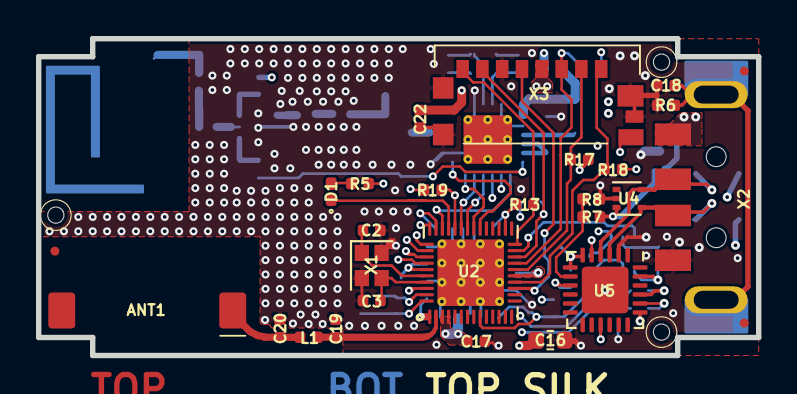
[picture p29: board nk-LoRa.kicad_pcb from above]

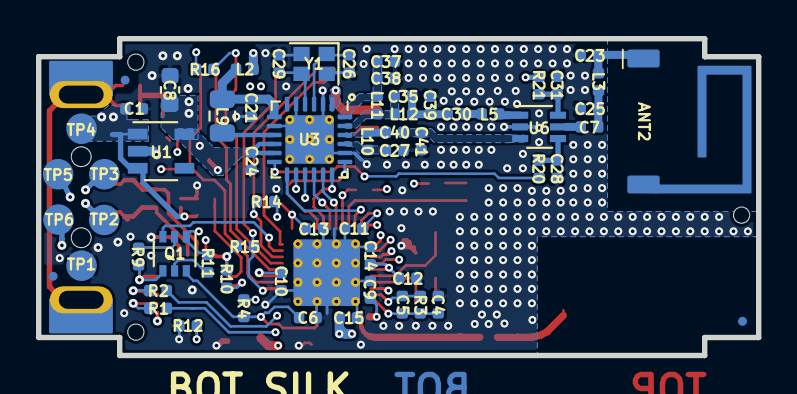
[picture p30: board nk-LoRa.kicad_pcb from below]

Board: 4 copper layers, 40.0 x 17.6 mm, 93 parts (65 on the bottom side), 61 nets.

Other parts of the board:
3D_*: case_bottom
FID3, FID3#2, FID3#3, FID3#4, FID3#5, FID3#6: Fiducial_0.5mm_Dia_1mm_Outer
